Pot4too/aether-node/hardware/solving_pmos/obrazky.pdf

## Simulácia PMOS ochrany napájania

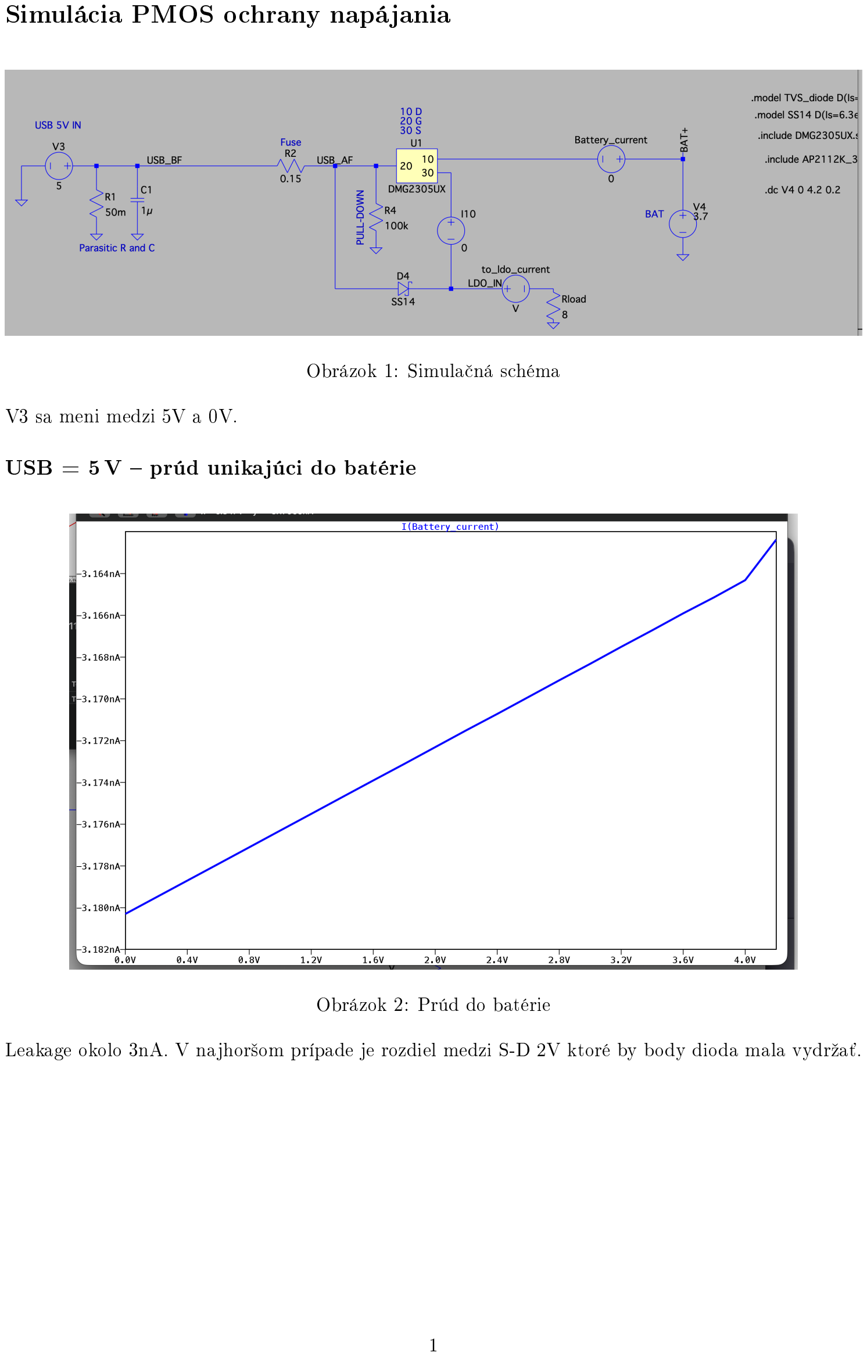
[picture p1: page 1]

Obrázok 1: Simula£ná schéma

V3 sa meni medzi 5V a 0V.

USB = 5 V prúd unikajúci do batérie

Obrázok 2: Prúd do batérie

Leakage okolo 3nA. V najhor²om prípade je rozdiel medzi S-D 2V ktoré by body dioda mala vydrºa´.

1

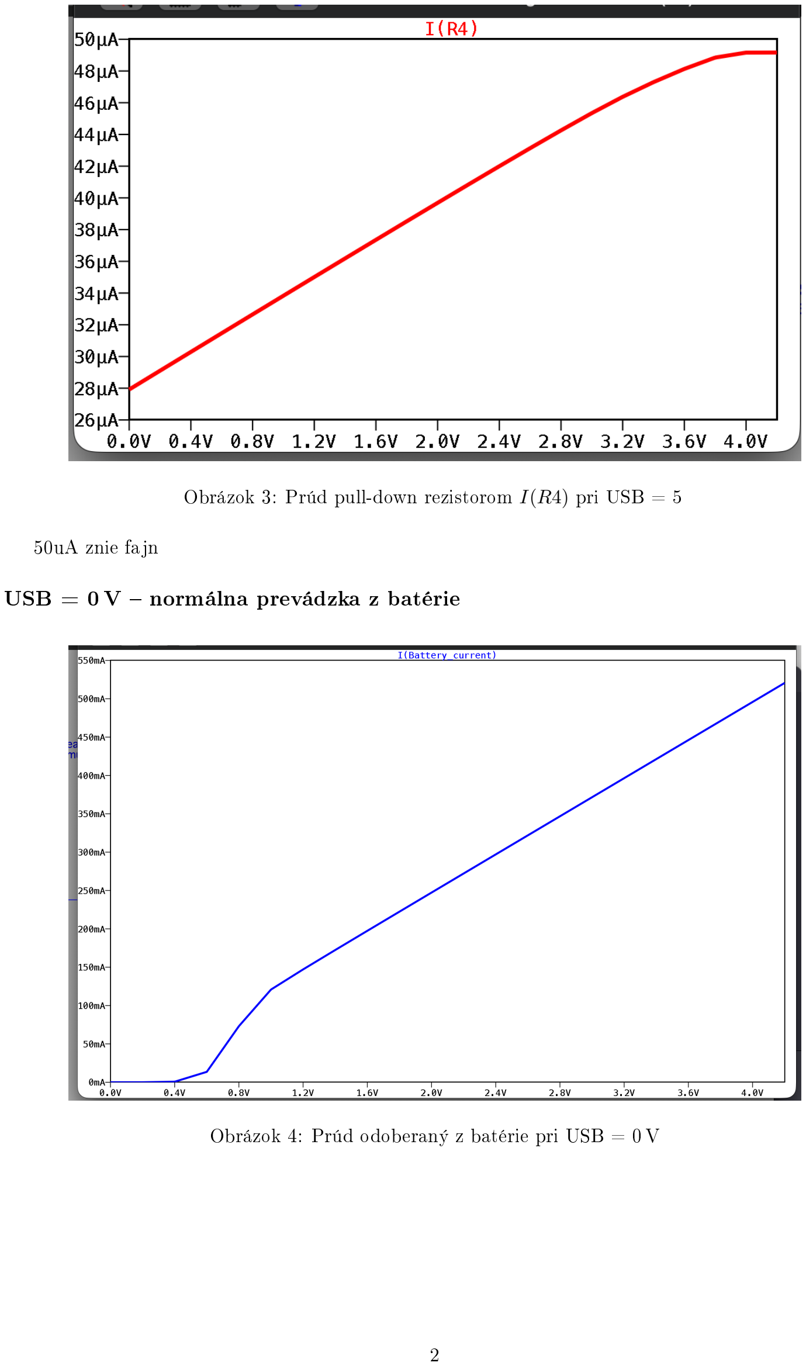
[picture p2: page 2]

Obrázok 3: Prúd pull-down rezistorom I(R4) pri USB = 5

50uA znie fajn

USB = 0 V normálna prevádzka z batérie

Obrázok 4: Prúd odoberaný z batérie pri USB = 0 V

2

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

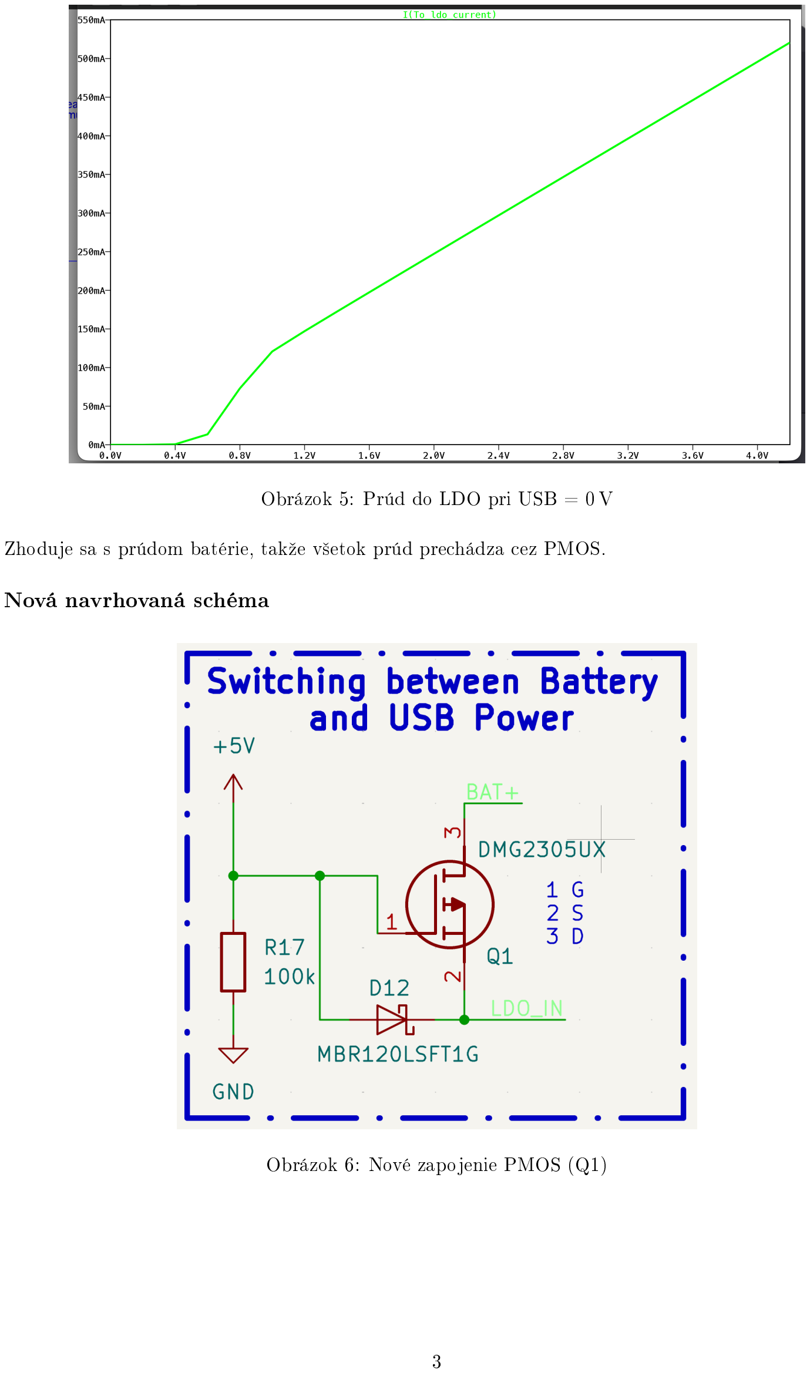
[picture p3: page 3]
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
