Pot4too/aether-node/hardware/solving_pmos/battery_current_0v.png

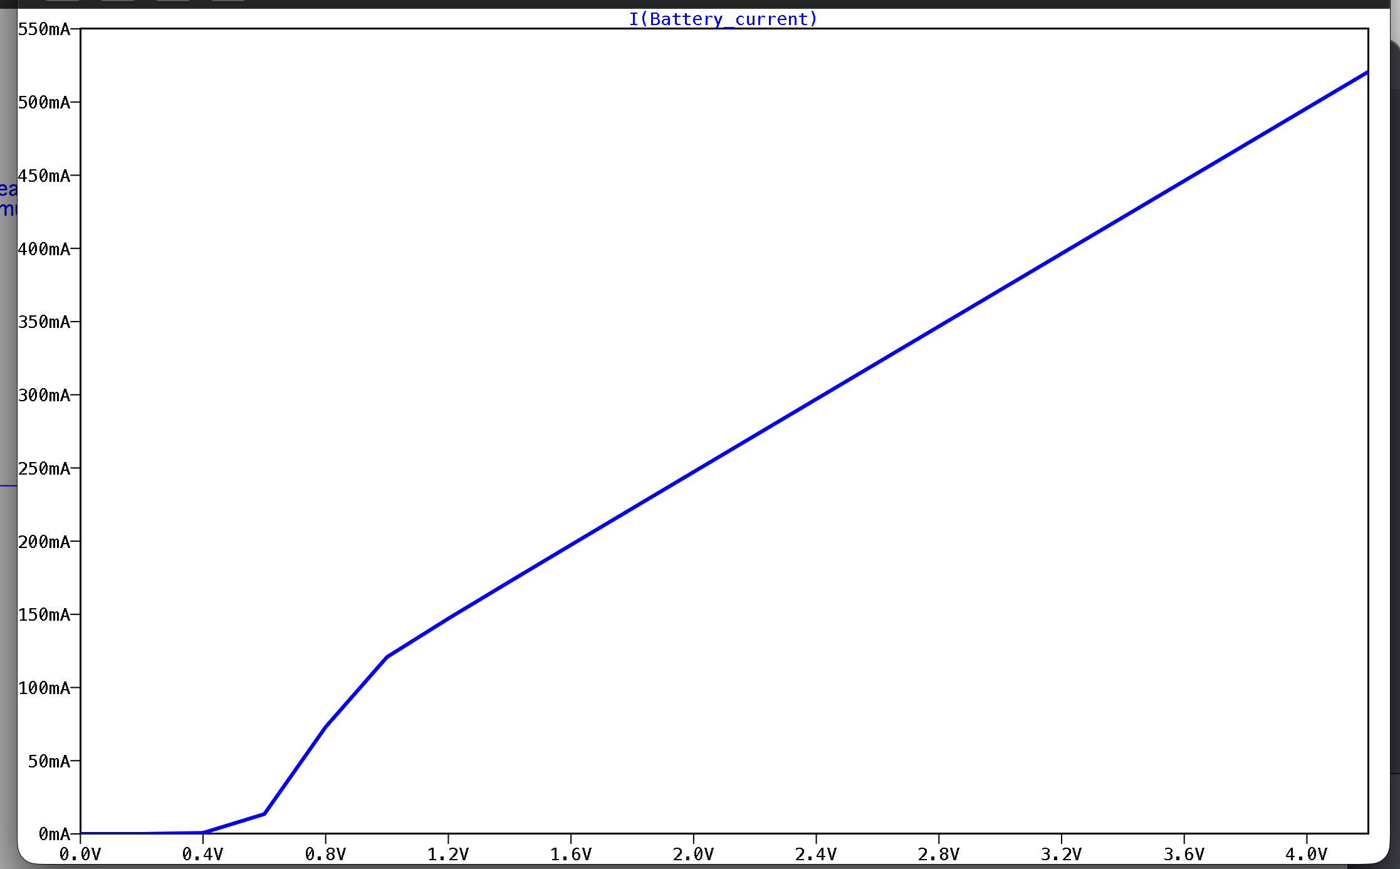
hardware/solving_pmos/battery_current_0v.png
