Pot4too/aether-node/hardware/solving_pmos/new_board_connection.png

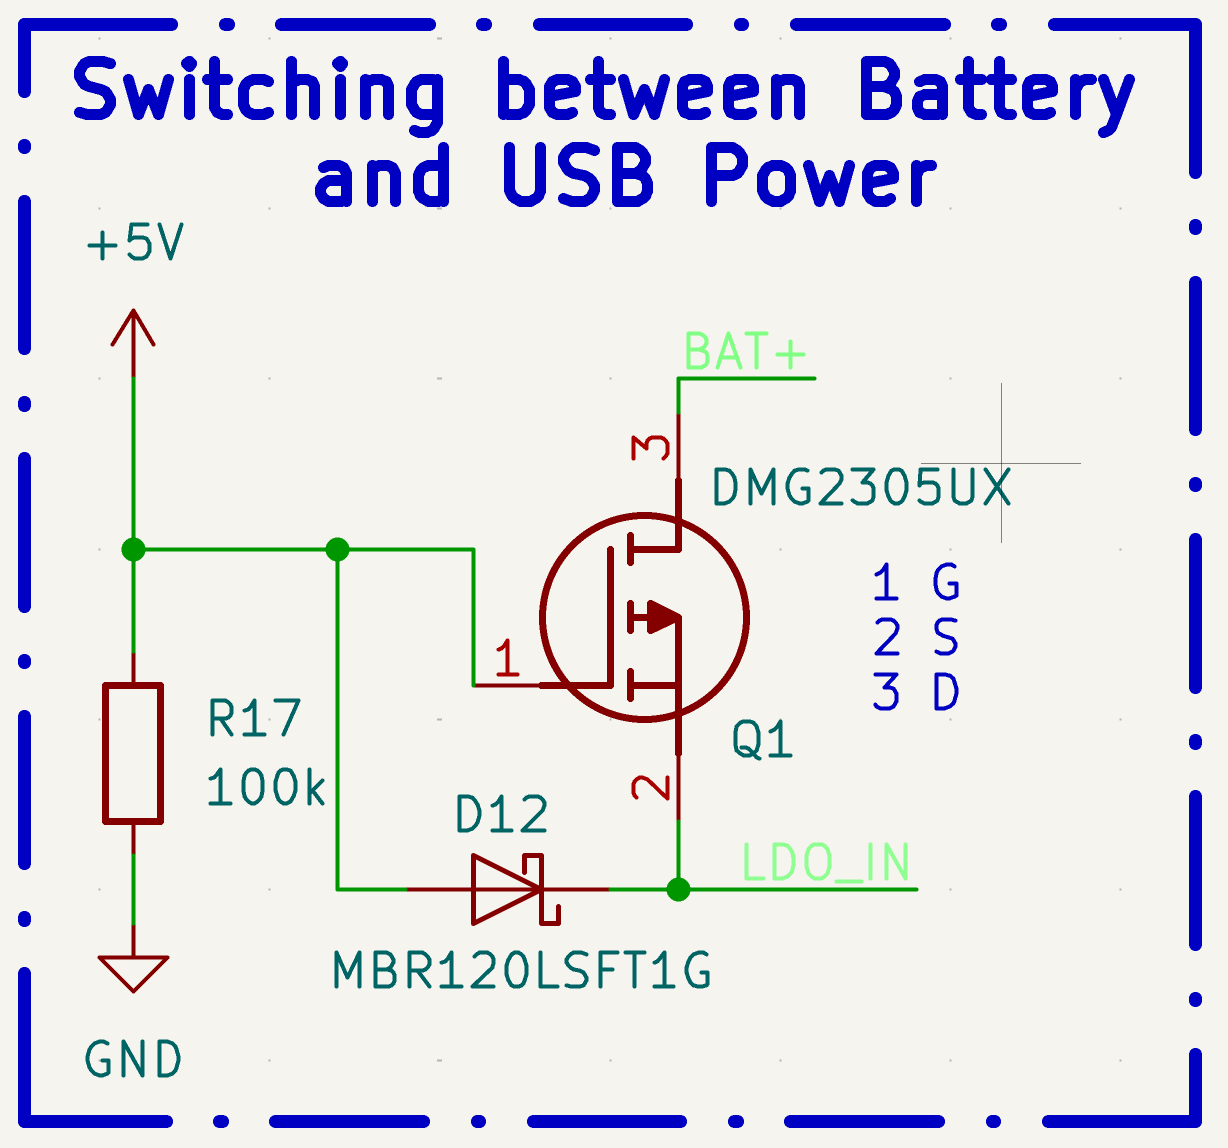
hardware/solving_pmos/new_board_connection.png
