Pot4too/aether-node/hardware/solving_pmos/prud_pull_down.png

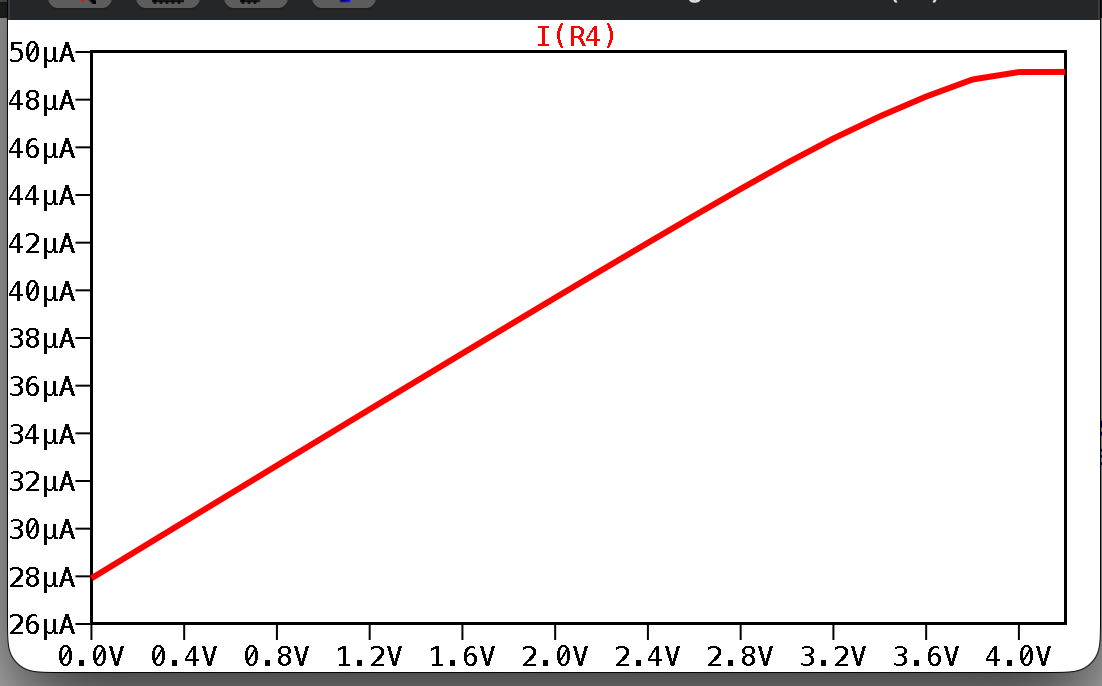
hardware/solving_pmos/prud_pull_down.png
