Pot4too/aether-node/hardware/main_board_parts_switch/Basket_Nov06_1112AM.xls

SHOPPING BASKET
This is not an invoice
06-Nov-26 11:12:10
 | Mouser No | Mfr. No | Manufacturer | Customer No | Description | RoHS | Lifecycle | Order Qty. | Price (EUR) | Ext.: (EUR)
1 | 511-USBLC6-2SC6 | USBLC6-2SC6 | STMicroelectronics |  | ESD Protection Diodes / TVS Diodes ESD Protection Low Cap | RoHS Compliant |  | 10 | 0,206 € | 2,06 €
2 | 621-AP2112K-3.3TRG1 | AP2112K-3.3TRG1 | Diodes Incorporated |  | LDO Voltage Regulators 600mA CMOS LDO 50mA 3.3V 250mV | RoHS Compliant |  | 10 | 0,157 € | 1,57 €
3 | 356-ESP32C6MINI-1-N4 | ESP32-C6-MINI-1-N4 | Espressif |  | Multiprotocol Modules ESP32-C6-MINI-1 is a ESP32-C6 based module, which supports Wi-Fi 6 in 2.4 GHz band, Bluetooth 5, Zigbee 3.0 and Thread. It's small-sized and pin-to-pin compatible with the ESP32-C3-MINI series module. With low power consumption, it is an ideal choice | RoHS Compliant |  | 3 | 3,90 € | 11,70 €
4 | 621-DMG2305UXQ-7 | DMG2305UXQ-7 | Diodes Incorporated |  | MOSFETs MOSFET BVDSS | RoHS Compliant |  | 10 | 0,175 € | 1,75 €
5 | 611-PCM12SMTR | PCM12SMTR | C&K Switches |  | Slide Switches 0.3A SPDT ON-ON | RoHS Compliant |  | 3 | 1,10 € | 3,30 €
6 | 611-PTS815SJM250SMTR | PTS815SJM250SMTR LFS | C&K Switches |  | Tactile Switches Tact Switch, 12 VDC, 50 mA, 4.2x3.2, 2.5mm H, 180gf, J leads | RoHS Compliant |  | 10 | 0,198 € | 1,98 €
7 | 187-CL21A226KOQNNNE | CL21A226KOQNNNE | Samsung Electro-Mechanics |  | Multilayer Ceramic Capacitors MLCC - SMD/SMT 22uF+/-10% 16V X5R 2 0805 | RoHS Compliant |  | 10 | 0,383 € | 3,83 €
8 | 710-150080VS75000 | 150080VS75000 | Wurth Elektronik |  | Single Colour LEDs WL-SMCW SMDMono TpVw Waterclr 0805 BrtGrn | RoHS Compliant |  | 20 | 0,163 € | 3,26 €
9 | 710-150080RS75000 | 150080RS75000 | Wurth Elektronik |  | Single Colour LEDs WL-SMCW SMDMono TpVw Waterclr 0805 Red | RoHS Compliant |  | 20 | 0,163 € | 3,26 €
10 | 863-MBR120LSFT1G | MBR120LSFT1G | onsemi |  | Schottky Diodes & Rectifiers 1A 20V | RoHS Compliant By Exemption |  | 10 | 0,526 € | 5,26 €
11 | 652-MF-NSMF150-2 | MF-NSMF150-2 | Bourns |  | Resettable Fuses - PPTC 6V 1.5A-HD 100A MAX | RoHS Compliant |  | 10 | 0,255 € | 2,55 €
12 | 306-SPH-001T-P0.5S | SPH-001T-P0.5S | JST |  | Terminals PH CONTACT | RoHS Compliant |  | 40 | 0,029 € | 1,16 €
13 | 306-SPH-002T-P0.5S | SPH-002T-P0.5S | JST |  | Terminals PH CONTACT | RoHS Compliant |  | 40 | 0,03 € | 1,20 €
14 | 306-PHR-4 | PHR-4 | JST |  | Headers & Wire Housings PH HOUSING | RoHS Compliant |  | 10 | 0,056 € | 0,56 €
15 | 306-B4BPHKSLFSNPP | B4B-PH-K-S(LF)(SN) | JST |  | Headers & Wire Housings PH HEADER (TOP TYPE) | RoHS Compliant |  | 14 | 0,143 € | 2,00 €
16 | 306-SM02BSRSSTBLFSN | SM02B-SRSS-TB(LF)(SN) | JST |  | Headers & Wire Housings SR HEADER (SMT SIDE) | RoHS Compliant |  | 12 | 0,28 € | 3,36 €
17 | 791-RMC1/10K512FTP | RMC1/10K5101FTP | Kamaya |  | Thick Film Resistors - SMD 5.1 kOhms 150 V 125 mW 1 % 0805 - 55 C / + 155 C 100 PPM / C |  |  | 16 | 0,026 € | 0,42 €
18 | 603-PT252FK-070R4L | PT2512FK-070R4L | YAGEO |  | Current Sense Resistors - SMD 400 mOhms 1 Watt 1 % 75 ppm/C AEC-Q200 | RoHS Compliant By Exemption |  | 10 | 0,275 € | 2,75 €
19 | 603-AC0805FR-7W2K4L | AC0805FR-7W2K4L | YAGEO |  | Thick Film Resistors - SMD Automotive Grade Chip Resistor 0805, 2.4kOhms, 1%, 1/8W | RoHS Compliant |  | 10 | 0,028 € | 0,28 €
20 | 652-MF-NSMF110-2 | MF-NSMF110-2 | Bourns |  | Resettable Fuses - PPTC 6V 1.1A-HD 100A MAX | RoHS Compliant |  | 10 | 0,249 € | 2,49 €
21 | 603-RT0805FRE10100KL | RT0805FRE10100KL | YAGEO |  | Thin Film Resistors - SMD 100K ohm 1% 50 ppm Thin Film | RoHS Compliant By Exemption |  | 10 | 0,015 € | 0,15 €
22 | 595-TPS2116DRLR | TPS2116DRLR | Texas Instruments |  | Power Switch ICs - Power Distribution 1.6V to 5.5V 40mOhm s 2.5A Low-IQ Pri | RoHS Compliant |  | 4 | 0,98 € | 3,92 €
23 | 637-SMF5.0CA | SMF5.0CA | Diotec Semiconductor |  | ESD Protection Diodes / TVS Diodes TVS, SOD-123FL, 150C, 200W, Bidir | RoHS Compliant By Exemption |  | 10 | 0,101 € | 1,01 €
By submitting your order you agree to these terms and conditions. (https://www.mouser.sk/saleterms) |  |  |  |  |  |  |  |  | Merchandise: | 59,82 €
Prices are reflected at the date and time shown. |  |  |  |  |  |  |  |  | Delivery Charge: | 25,00 €
