Pot4too/aether-node/hardware/main_board_parts_switch/final_after_update_board/techfun_order.csv

Supplier PN | MPN | Quantity | Manufacturer | Description | Unit price EUR | Line total EUR | Designators | URL | Note
 |  | 6 |  | Lithium Battery 1A ESOP-8 Battery Management RoHS | 0.19 | 1.14 | U4 | https://techfun.sk/produkt/nabijaci-modul-tp4056-samostatny-cip-sop8-1a/ | Replacement for TP4056-42-ESOP8: Missing the exposed heatpad underneath (SOP-8 instead of ESOP-8)
