Pot4too/aether-node/hardware/simulation/main-board/power-delivery.asc

C1: Cap; 1µ
C2: Cap; 1µ; Rser=10m
C3: Cap; 100n; Rser=15m
C4: Cap; 1µ; Rser=10m
C5: Cap; 22µ; Rser=5m
D1: zener; BZX84C6V2L
D2: zener; TVS_diode
D3: zener; TVS_diode
D4: schottky; SS14
R1: Res; 50m
R2: Res; 0.15
R3: Res; 1G
R4: Res; 10k
U1: DMG2305UX
U2: AP2112K_33
V3: Voltage; 5
V4: Voltage; 3.7; Rser=25m
Named nets: 0, BAT+, USB_AF, USB_BF, LDO_IN, LDO_OUT
Ideally we would need to simulate whole power newtork from USB and Battery to MCU input
Simulate LDO as a voltage driven voltage source
USB 5V IN
Parasitic R and C
.model TVS_diode D(Is=1e-14 Rs=0.07 Bv=5.7 Ibv=10m Nbv=3 Cjo=200p)
For LTspice to not complain
BtB TVS Diode
Fuse
.include DMG2305UX.spice.txt
10 D
20 G
30 S
BAT
PULL-DOWN
.model SS14 D(Is=6.3e-8 N=1.05 Rs=0.05 Eg=0.69 Xti=2 Cjo=150p Vj=0.4 M=0.5 Bv=40 Ibv=200u Tt=1n)
MISSING BEHAVIRAL 
MODEL FOR LDO
.include AP2112K_33.sub
;.tran 150m
;.step param VBAT list 3.0 3.7 4.2
;.dc V3 list 0 5 8 V4 list 3 3.7 4.2
;.dc V4 list 3 3.7 4.2
.dc V3 list 0 5 8 20
