Pot4too/aether-node/hardware/main-board/main-board.kicad_pcb

## KiCad design hardware/main-board/main-board.kicad_pcb (2026-11-13)

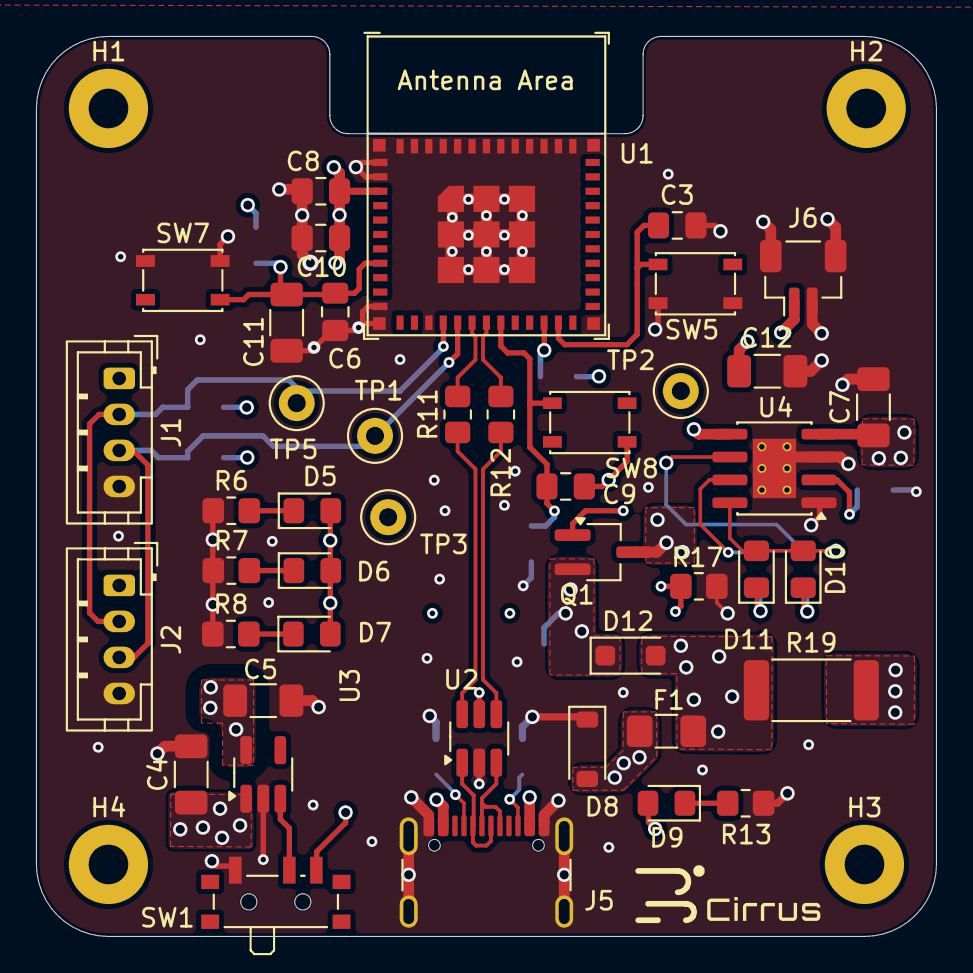
[picture p7: board main-board.kicad_pcb from above]

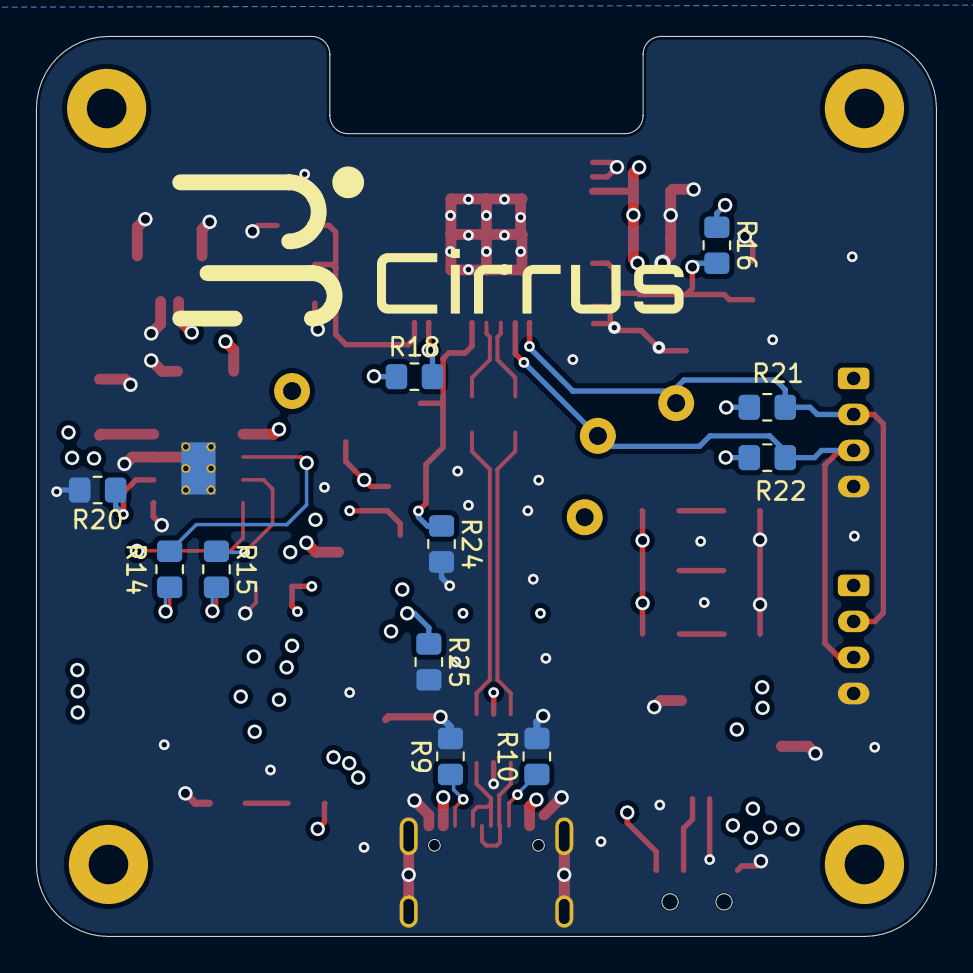
[picture p8: board main-board.kicad_pcb from below]

Board: 4 copper layers, 50.0 x 50.0 mm, 59 parts (11 on the bottom side), 31 nets.

Parts:
C3, C6, C9, C10: 100n; C_0805_2012Metric_Pad1.18x1.45mm_HandSolder
C4, C5, C11: 1u; C_1206_3216Metric_Pad1.33x1.80mm_HandSolder
C7, C12: 10u; C_1206_3216Metric_Pad1.33x1.80mm_HandSolder
C8: 22u; C_0805_2012Metric_Pad1.18x1.45mm_HandSolder
D5, D6, D9, D10: LED Green; LED_0805_2012Metric_Pad1.15x1.40mm_HandSolder
D7, D11: LED Red; LED_0805_2012Metric_Pad1.15x1.40mm_HandSolder
D8: FUXINSEMI SMF5.0CA; D_SOD-123
D12: MBR120LSFT1G; D_SOD-123F
F1: NSMD150/16; Fuse_1206_3216Metric_Pad1.42x1.75mm_HandSolder
H1, H2, H3, H4: MountingHole; MountingHole_2.2mm_M2_Pad
J1, J2: Conn_01x04_Socket; JST_PH_B4B-PH-K_1x04_P2.00mm_Vertical
J5: USB_C_Receptacle_USB2.0_16P; USB_C_Receptacle_GCT_USB4105-xx-A_16P_TopMnt_Horizontal
J6: Conn_01x02_MountingPin; JST_SH_BM02B-SRSS-TB_1x02-1MP_P1.00mm_Vertical
Q1: DMG2305UX; TSOT-23_HandSoldering
R6, R7, R8: 90; R_0805_2012Metric_Pad1.20x1.40mm_HandSolder
R9, R10, R20: 5.1k; R_0805_2012Metric_Pad1.20x1.40mm_HandSolder
R11, R12: 22; R_0805_2012Metric_Pad1.20x1.40mm_HandSolder
R13, R14, R15: 200; R_0805_2012Metric_Pad1.20x1.40mm_HandSolder
R16, R18, R24: 10k; R_0805_2012Metric_Pad1.20x1.40mm_HandSolder
R17, R25: 100k; R_0805_2012Metric_Pad1.20x1.40mm_HandSolder
R19: 0.4; R_2512_6332Metric_Pad1.40x3.35mm_HandSolder
R21, R22: 4.7k; R_0805_2012Metric_Pad1.20x1.40mm_HandSolder
SW1: C&K PCM12SMTR; SW_SPDT_PCM12
SW5, SW7, SW8: C&K PTS815SJM250SMTR LFS; SW_SPST_PTS810
TP1, TP2, TP3, TP5: TestPoint; TestPoint_Loop_D1.80mm_Drill1.0mm_Beaded
U1: ESP32-C6-MINI-1/U; ESP32-C6-MINI-1
U2: USBLC6-2SC6; SOT-23-6_Handsoldering
U3: AP2112K-3.3; SOT-23-5_HandSoldering
U4: TP4056-42-ESOP8; SOIC-8-1EP_3.9x4.9mm_P1.27mm_EP2.41x3.3mm_ThermalVias

Connections:
+3.3V: C5.1, C8.2, C9.1, C10.1, D5.2 (A), D6.2 (A), D7.2 (A), J1.1, J2.1, R16.1, R18.1, R21.1, R22.1, SW8.1, TP3.1 (1_1), U1.3 (3V3), U3.5 (VOUT)
+5V: D9.2 (A), D12.2 (A), F1.2, Q1.1 (G), R17.1, R19.1
/BAT+: C12.1, J6.1, Q1.3 (D), TP2.1 (1_1), U4.5 (BAT)
/BOOT: C3.1, SW5.1, U1.23 (GPIO9)
/EN: C6.2, C11.1, R16.2, SW7.2, U1.8 (EN/CHIP_PU)
/IO8: R18.2, U1.22 (GPIO8)
/IO14: C9.2, R24.1, SW8.2, U1.19 (GPIO14)
/LDO_IN: C4.1, D12.1 (K), Q1.2 (S), R25.1, SW1.3 (C), U3.1 (VIN)
/SCL: J1.3, J2.3, R22.2, TP1.1 (1_1), U1.16 (MTDO/GPIO7)
/SDA: J1.2, J2.2, R21.2, TP5.1 (1_1), U1.15 (MTCK/GPIO6/ADC1_CH6)
/USB+: R12.1, U1.18 (GPIO13/USB_D+)
/USB-: R11.2, U1.17 (GPIO12/USB_D-)
/USB_CONN_D+: J5.A6 (D+), J5.B6 (D+), U2.3 (I/O2)
/USB_CONN_D-: J5.A7 (D-), J5.B7 (D-), U2.1 (I/O1)
/USB_ESD_D+: R12.2, U2.4 (I/O2)
/USB_ESD_D-: R11.1, U2.6 (I/O1)
GND: C3.2, C4.2, C5.2, C6.1, C7.2, C8.1, C10.2, C11.2, C12.2, D8.1 (A1), J1.4, J2.4, J5.A1 (GND), J5.A12 (GND), J5.B1 (GND), J5.B12 (GND), J5.SH (SHIELD), J6.2, J6.MP (MountPin), R6.1, R7.1, R8.1, R9.2, R10.2, R13.2, R17.2, R20.2, R24.2, R25.2, SW1.1 (A), SW5.2, SW7.1, U1.1 (GND), U1.2 (GND), U1.11 (GND), U1.14 (GND), U1.36 (GND), U1.37 (GND), U1.38 (GND), U1.39 (GND), U1.40 (GND), U1.41 (GND), U1.42 (GND), U1.43 (GND), U1.44 (GND), U1.45 (GND), U1.46 (GND), U1.47 (GND), U1.48 (GND), U1.49 (GND), U1.50 (GND), U1.51 (GND), U1.52 (GND), U1.53 (GND), U2.2 (GND), U3.2 (GND), U4.1 (TEMP), U4.3 (GND), U4.9 (EPAD)
unnamed: D5.1 (K), R6.2
unnamed: D6.1 (K), R7.2
unnamed: D7.1 (K), R8.2
unnamed: D8.2 (A2), F1.1, J5.A4 (VBUS), J5.A9 (VBUS), J5.B4 (VBUS), J5.B9 (VBUS), U2.5 (VBUS)
unnamed: D9.1 (K), R13.1
unnamed: C7.1, D10.2 (A), D11.2 (A), R19.2, U4.4 (V_{CC}), U4.8 (CE)
unnamed: D10.1 (K), R14.2
unnamed: D11.1 (K), R15.2
unnamed: J5.A5 (CC1), R10.1
unnamed: J5.B5 (CC2), R9.1
unnamed: SW1.2 (B), U3.3 (EN)
unnamed: R20.1, U4.2 (PROG)
unnamed: R15.1, U4.7 (~CHRG)
unnamed: R14.1, U4.6 (~STDBY)
