Pot4too/aether-node/(commit log)

2026-06-27 Initialized PlatformIO in firmware directory
    firmware sub-directory contains its own .gitignore file
    platformio.ini is set for board ESP32-C6 Super Mini
2026-06-28 Test main file to see if board and setup works correctly
    [main.c]
2026-10-07 This is a initial commit from rebasing the project from onedrive to github. Main reason is better version control of each part of the project
    Too many things moved, reordered folders. There is no point in listing
    each change but this repo was copied from latest onedrive version
    [main-board.kicad_pcb, main-board.kicad_sch]
2026-10-08 Added overvoltage protection to schematic
    Layout Needs to be rerouted
    [main-board.kicad_pcb, main-board.kicad_sch]
2026-10-08 After deciding we wont include OVP in this design, so i removed it from active schematic and check if everything is alright in pcb
    [main-board.kicad_pcb, main-board.kicad_sch]
2026-10-08 Create a kicad10 project for a sensor board
    It will stay empty for now. I planned on making a board consisitng of
    couple of sensor boards separated by mousebites which i would than cut.
    For now I will go with premade sensor boards (with I2C interface) and
    handsolder my connector cables to it.
    [sensor-board.kicad_pcb, sensor-board.kicad_sch]
2026-10-10 Added a python web for easier checking between BOM and supplier cart
    I can make notes and check each part. It can be used on different
    boards, the metadata is created/stored in each board project
    [main-board.csv, main-board.kicad_sch]
2026-11-01 Replaced button and slide switch parts
    Tactile switch to C&K PTS815SJM250SMTR LFS
    Slide switch to C&K PCM12SMTR
    Updated tactile swtches footprints and connections according to new part
    Slide switch footprint is the same but the connectons have changed due
    to lower specs of the switch (from 1A to 300mA holding current). The
    switch now only switches EN pin of the 5V to 3.3V regulator (between GND
    and 5V).
2026-11-01 Changed battery charging current from 500mA to 250mA
    Replaced R20 from 2.4kOhm to 5.1kOhm based on datasheet of the TP4056
    battery charger IC
2026-11-01 Added BOMs and description to schematic about chargin current
    Added a note for R = 5.1kOhm that its for 250mA charging
    Added a folder which contains two webpages - Part editor for editing
    each part and adding equivalent parts from different retailers. Second
    called part pricing used for generating final list of all parts,
    quantities and retailers for easier managment and ordering.
2026-11-12 Updates to board and schematic
    Switched D and S of PMOS so the body diode is in reverse.
    Added 100k Resistor for LDO_IN net so when the LDO is off we have a
    definitive potential on the S of PMOS
    Changed 10k for 100k as pulldown on G of PMOS to draw less power
2026-11-12 Mouser order list and Claude board review
2026-11-13 Aether-Node Cirrus (v1)
    Added Logo and Name of the first version of the board to PCB
